jhlr/plotter/pecas_impressao/engrenagem_trilho_corte.png

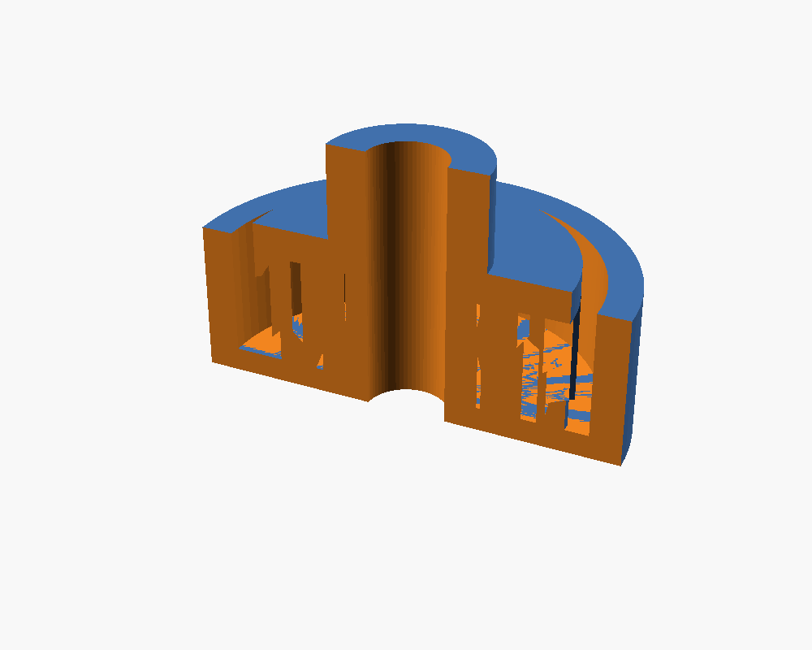
pecas_impressao/engrenagem_trilho_corte.png
