jhlr/plotter/pecas_impressao/engrenagem_trilho_iso.png

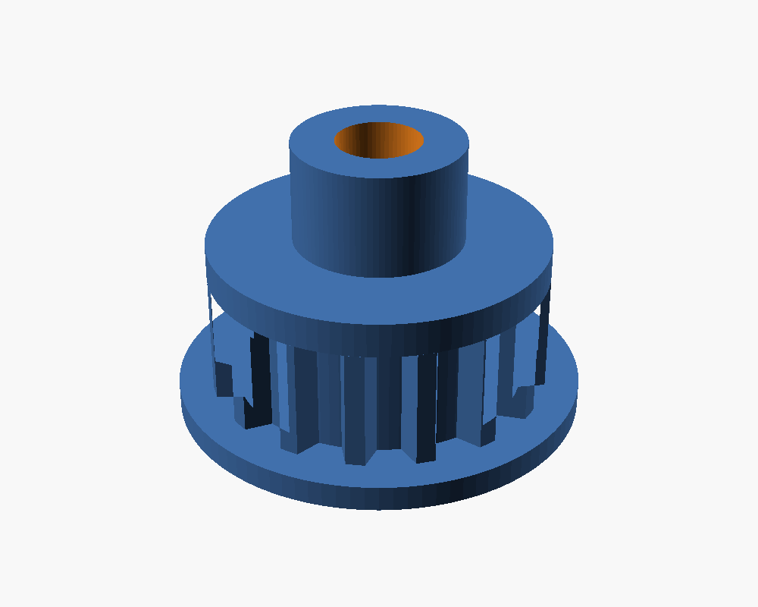
pecas_impressao/engrenagem_trilho_iso.png
