jhlr/plotter/pecas_impressao/ELO_2.stl

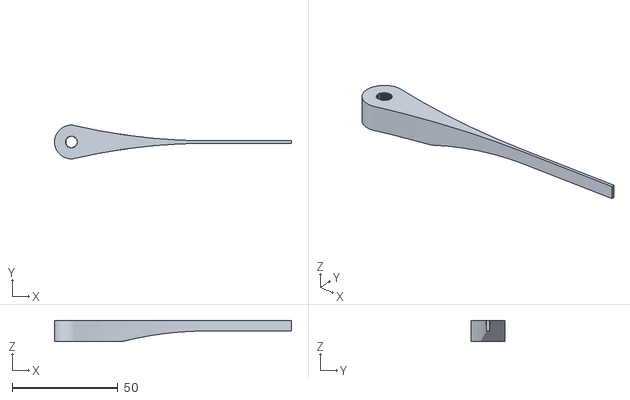
[picture p3: CAD file, 2026-10-28]
pecas_impressao/ELO_2.stl
112.2 x 16.0 x 10.0
