jhlr/plotter/pecas_impressao/ELO_1.stl

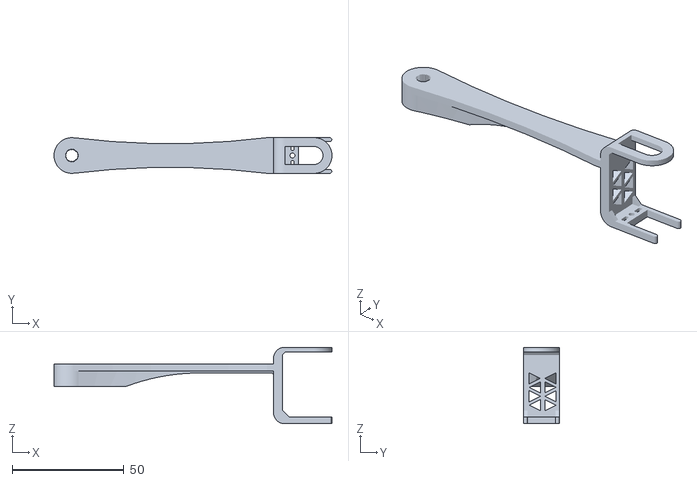
[picture p4: CAD file, 2026-10-28]
pecas_impressao/ELO_1.stl
124.6 x 16.0 x 34.2
