jhlr/plotter/pecas_impressao/engrenagem_trilho.stl

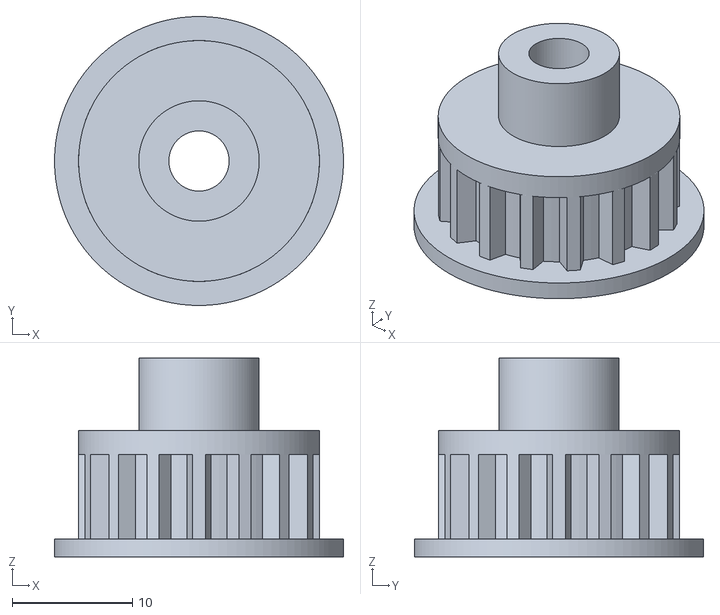
[picture p5: CAD file, 2026-10-28]
pecas_impressao/engrenagem_trilho.stl
24.0 x 24.0 x 16.5
