jhlr/plotter/pecas_impressao/SUPORTE_LAPIS.stl

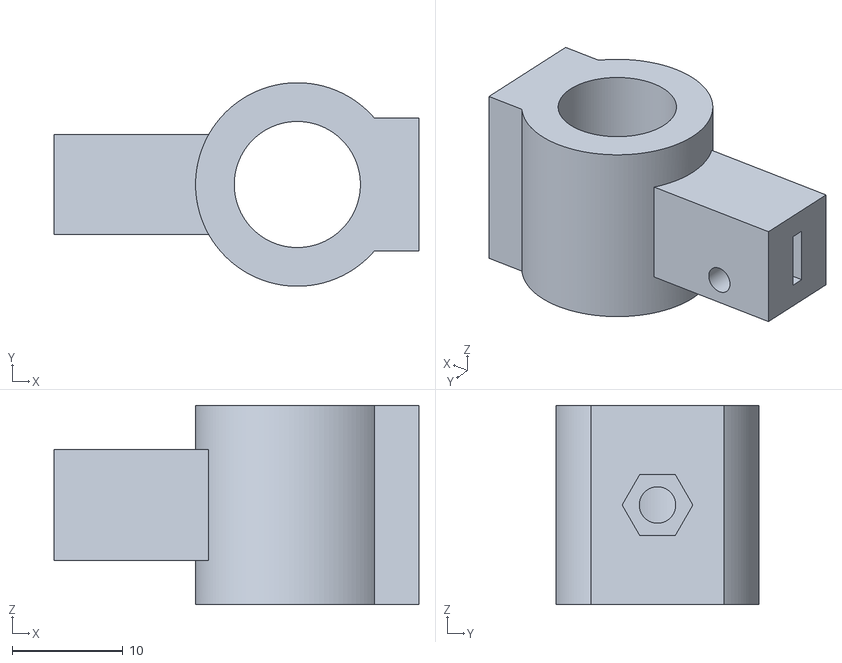
[picture p6: CAD file, 2026-10-28]
pecas_impressao/SUPORTE_LAPIS.stl
33.0 x 18.4 x 18.0
