jhlr/plotter/pecas_impressao/BASE.stl

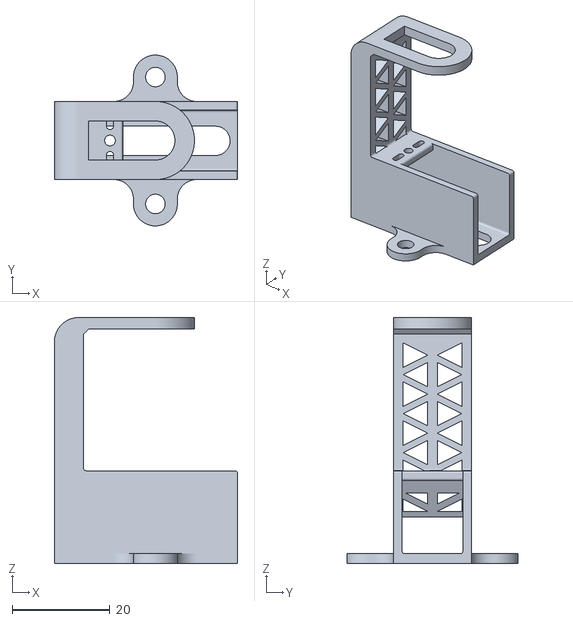
[picture p7: CAD file, 2026-10-28]
pecas_impressao/BASE.stl
37.6 x 35.0 x 50.4
