jhlr/plotter/firmware/src/config.h

#pragma once
// Board abstraction: pins, servo library and ADC range for each supported controller.
// Select with the PlatformIO env (esp32 / uno / servotest / servotest_uno); nothing else is board-specific.
#include <Arduino.h>

#if defined(ARDUINO_ARCH_ESP32)
#include <ESP32Servo.h>
constexpr int PIN_SERVO1 = 18;
constexpr int PIN_SERVO2 = 19;
constexpr int PIN_POT1 = 34;  // ADC1, input only
constexpr int PIN_POT2 = 35;
constexpr int ADC_MAX = 4095;  // 12-bit
#define PERSIST_POSE 0
#define PROGRAM_STEPS 0  // no on-board stored drawing (needs the Uno's EEPROM)
constexpr int QUEUE_SIZE = 512;  // waypoints buffered on the board
#elif defined(ARDUINO_ARCH_AVR)  // Arduino Uno
#include <Servo.h>
// Servo lib takes over Timer1: PWM on 9/10 is unavailable (fine for servos).
// Wired on the real arm: proximal servo (shoulder, servo 1) on D9, distal servo (elbow, servo 2) on D8.
constexpr int PIN_SERVO1 = 9;
constexpr int PIN_SERVO2 = 8;
constexpr int PIN_POT1 = A0;
constexpr int PIN_POT2 = A1;
constexpr int ADC_MAX = 1023;  // 10-bit
// Every port open auto-resets the Uno (the Windows CH340 driver pulses DTR even when told not to). Keep the last
// pose in EEPROM as the starting estimate; the servos stay released at boot so the arm is never moved by a reset.
#define PERSIST_POSE 1
constexpr int QUEUE_SIZE = 64;  // waypoints buffered on the board (4 bytes each; the Uno has 2 KB of RAM)
// A drawing stored in EEPROM (1 KB): 8-byte header at address 32, then 2 bytes per step (int8 deltas, 0.1 degree).
// 0..15 = last pose, 16..17 = boot counter (see bootId).
#define PROGRAM_STEPS 492
#else
#error "Unsupported board: add its pins to src/config.h"
#endif

// 115200 dropped ~40% of reply lines on a CH340 Uno clone (Windows driver 3.9); 57600 had 0 errors in 400.
#ifndef PENARM_BAUD  // override with -DPENARM_BAUD=... (build_flags); the server's SerialLink must match
#define PENARM_BAUD 57600
#endif

constexpr int PULSE_MIN_US = 500;
constexpr int PULSE_MAX_US = 2400;

inline void boardInit() {
#if defined(ARDUINO_ARCH_ESP32)
  analogReadResolution(12);
#endif
}

// A value that differs on every boot, reported by '?' so the host can tell the board restarted (brown-out, cable bump).
// ESP32: random. Uno: a counter in EEPROM (one write per boot).
#if defined(ARDUINO_ARCH_AVR)
#include <EEPROM.h>
#endif
inline uint16_t bootId() {
#if defined(ARDUINO_ARCH_ESP32)
  return (uint16_t)esp_random();
#else
  constexpr int BOOT_ADDR = 16;
  uint16_t n;
  EEPROM.get(BOOT_ADDR, n);
  n++;
  EEPROM.put(BOOT_ADDR, n);
  return n;
#endif
}
