jhlr/plotter/server/tests/test_kinematics.py

import math

import pytest

from penarm.arm import Arm
from penarm.config import ArmConfig
from penarm.errors import Unreachable
from penarm.kinematics import fk, ik, interpolate, page_to_servos
from penarm.link import SimLink

CFG = ArmConfig()


@pytest.mark.parametrize("elbow_up", [True, False])
@pytest.mark.parametrize("pt", [(105.0, 100.0), (60.0, 150.0), (140.0, 60.0)])
def test_ik_fk_roundtrip(pt: tuple[float, float], elbow_up: bool) -> None:
    cfg = ArmConfig(elbow_up=elbow_up)
    x, y = fk(cfg, *ik(cfg, *pt))
    assert math.dist((x, y), pt) < 1e-6


def test_unreachable_far_point() -> None:
    with pytest.raises(Unreachable):
        ik(CFG, 105.0, 500.0)


def test_outside_page_rejected() -> None:
    with pytest.raises(Unreachable):
        page_to_servos(CFG, -5.0, 100.0)


def test_interpolate_ends_at_target() -> None:
    pts = interpolate((0, 0), (10, 0), 1.0)
    assert len(pts) == 10 and pts[-1] == (10, 0)


def test_failed_path_moves_nothing() -> None:
    link = SimLink()
    arm = Arm(CFG, link)
    with pytest.raises(Unreachable):
        arm.draw_polyline([(105.0, 100.0), (105.0, 100.5), (999.0, 999.0)])
    assert link.history == []


def test_circle_closes_and_stays_on_radius() -> None:
    from penarm.shapes import arc_points

    pts = arc_points(105.0, 100.0, 20.0, 0.0, 360.0)
    assert math.dist(pts[0], pts[-1]) < 1e-9
    assert all(abs(math.dist(p, (105.0, 100.0)) - 20.0) < 1e-9 for p in pts)
    # chord midpoints deviate from the circle by <= tol
    mids = [((a[0] + b[0]) / 2, (a[1] + b[1]) / 2) for a, b in zip(pts, pts[1:])]
    assert all(20.0 - math.dist(m, (105.0, 100.0)) <= 0.1 + 1e-9 for m in mids)


def test_clockwise_arc_direction() -> None:
    from penarm.shapes import arc_points

    pts = arc_points(0.0, 0.0, 10.0, 90.0, 0.0)
    assert pts[0][1] > pts[-1][1] and pts[-1][0] > pts[0][0]
