jhlr/plotter/(commit log)

2026-10-21 Pen plotter arm: ESP32 firmware + MCP server
2026-10-21 MCP: draw_arc/draw_circle, LLM-readable tool errors
    [server.py, shapes.py, test_kinematics.py]
2026-10-21 Vision: overhead camera pencil locator (ArUco homography + color tag), locate_pencil MCP tool
2026-10-22 Firmware: Arduino Uno support via config.h, standalone servo test
2026-10-22 Uno + CH340 bring-up: reliable serial, measured arm, boot at last pose
    - Serial at 57600 baud (PENARM_BAUD in config.h): at 115200 a CH340 Uno
    clone dropped ~40% of reply lines; 57600 had 0 errors in 400.
    - SerialLink: the Windows CH340 driver (3.9) fails SetCommState when the
    port is set to the baud it already has, so open at 9600, switch once and
    never reconfigure (fixed port timeout, own deadline per command). Wait for
    the Uno bootloader after open. Resend idempotent commands after a lost
    byte, with the wait sized from the move's travel time.
    - Firmware: writeMicroseconds instead of write() (whole degrees turned
    ramps into 1-degree steps). On the Uno the resting pose is kept i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
    [arm.py, config.h, config.py, kinematics.py, link.py, main.cpp]
2026-10-23 Calibrate offsets/base from overhead photo, CAD link lengths, boot wait, surface hardware errors to the LLM
    [config.py, link.py, server.py]
2026-10-23 MCP: canvas frame, line/rect/bezier tools, calibration mode with fitter; pins swapped (proximal D10, distal D9)
    [arm.py, calibration.py, canvas.py, config.h, server.py, shapes.py, test_canvas_calibration.py]
2026-10-25 MCP: trajectory language (draw_path/svg/shapes), dry_run preview, async jobs with stop, port lock, reset detection, photo-based paper calibration; firmware boot id + idle release
    [arm.py, calibration.py, config.h, config.py, errors.py, fakes.py, jobs.py]
2026-10-25 Board-side execution queue (sequenced waypoints, abort, reset detection); provider-portable tool schemas with a guard test; server usage guide
    [arm.py, config.h, fakes.py, link.py, main.cpp, paths.py, server.py]
2026-10-25 Phone-photo vision (ruled block + pen holder, plausibility checks, parallax correction) with analyze_photo / record_photo_observation_auto
    [photocv.py, server.py, test_photocv.py]
2026-10-28 Timed continuous motion, EEPROM stored drawings, resumable drawings, speed profile, ink-based calibration mesh
    Firmware: timed segments with synchronised servos (Q takes an optional ms), EEPROM program (PB/PD/PE/PI/G), pose saved on abort.
    Host: speed profile, journal + resume_drawing, stricter reply parsing and resend, correction mesh stored in calibration.json, canvas computed from where the arm aims, full 0-180 servo range.
    [arm.py, calibration.py, canvas.py, config.h, config.py, fakes.py, journal.py, link.py]
2026-10-28 README: quick start for a new machine (wiring, flashing with verify, port, running, stored drawings, resume, mesh calibration)
2026-10-28 Replicable repo: README rewritten (BOM, wiring, bring-up, MCP install, troubleshooting), penarm-inkcal --ink for ballpoint/other pen colours, 3D-printed parts tracked
    [BASE.stl, ELO_1.stl, ELO_2.stl, SUPORTE_LAPIS.stl, engrenagem_trilho.scad, engrenagem_trilho.stl]
